Maaskas/Linefollower-2/readme.md

# LineFollower

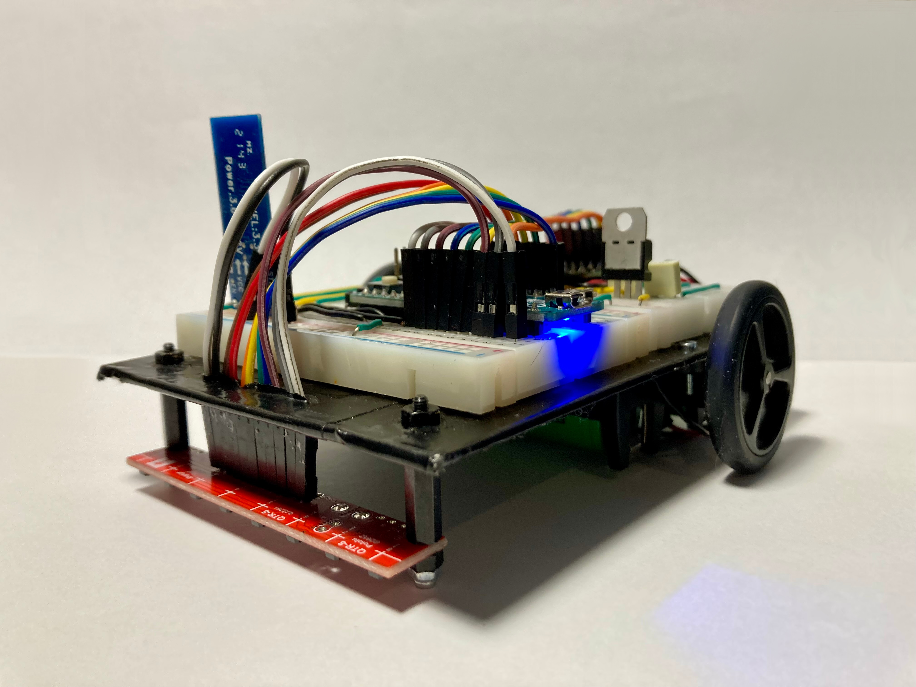
[picture p1: images/LFR.jpg]
A description of my image


## specifications

microcontroller: ATmega32U4

motors: 50:1 Geamotor 6V

h-bridge: TB6612FNG

sensors: QTR-8A

batteries: Sony US 18650VTC5C, 2500mAh, 30A

wireless communication: HC-05

distance sensor - motors: 85 mm

weight: 289 gram

speed: 0,82m/s
