Maaskas/Linefollower-2/code/proof of concepts/wireless communication/readme.md

# draadloze communicatie proof of concept
minimale hard- en software waarmee aangetoond wordt dat duplex kan gecommuniceerd worden tussen de microcontroller en een smartphone, gebruik makend van een Arduino programma
<br />
### configuratie

### opmerkingen

### gebruiksaanwijzing
