Maaskas/Linefollower-2/code/proof of concepts/sensor/readme.md

# Sensoren proof of concept

minimale hard- en software die aantoont dat minimaal 6 sensoren onafhankelijk van elkaar kunnen uitgelezen worden (geen calibratie, normalisatie of interpolatie). Hierbij moet een zo groot mogelijk bereik van de AD converter benut worden (indien van toepassing)

A description of my image
