Maaskas/Linefollower-2/images/IMG_2840.jpg

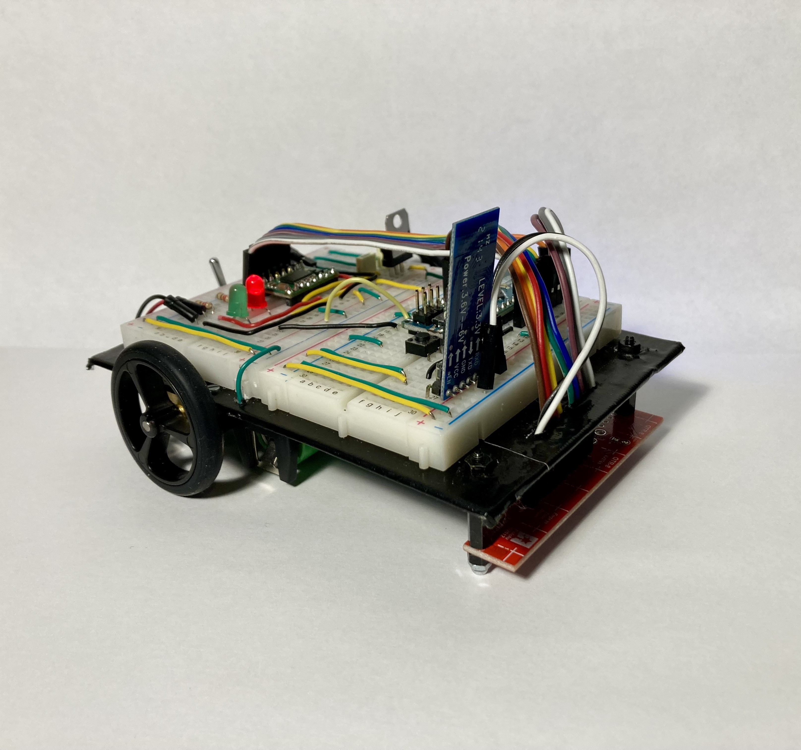
images/IMG_2840.jpg
