Maaskas/Linefollower-2/images/IMG_2842.jpg

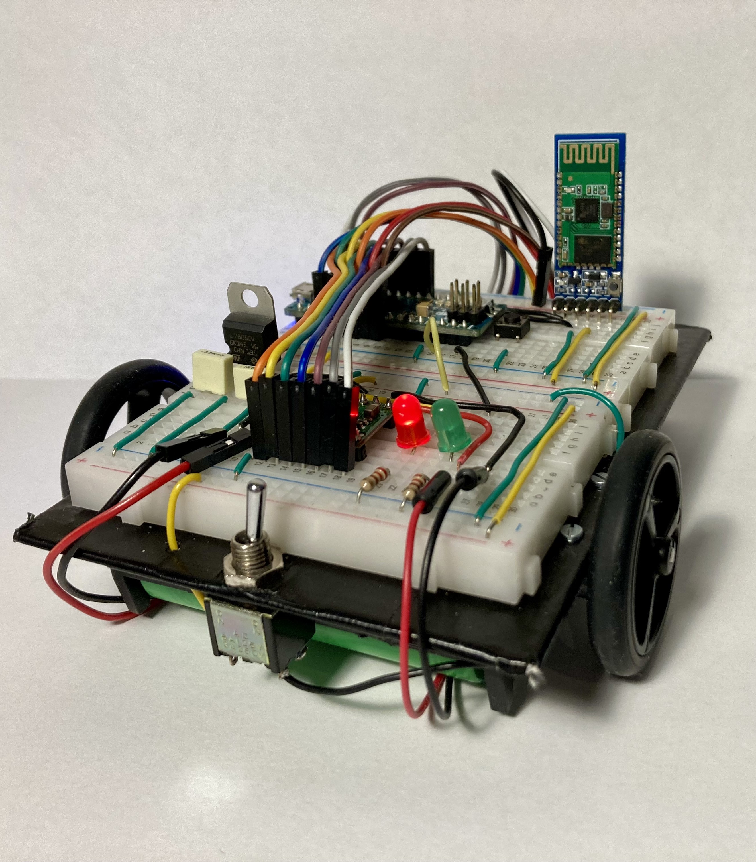
images/IMG_2842.jpg
