Maaskas/Linefollower-2/images/IMG_2843.jpg

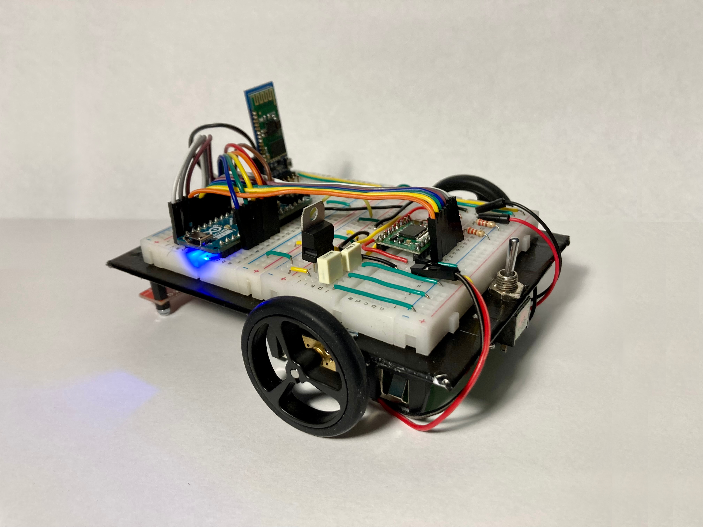
images/IMG_2843.jpg
