Maaskas/Linefollower-2/images/IMG_2844.jpg

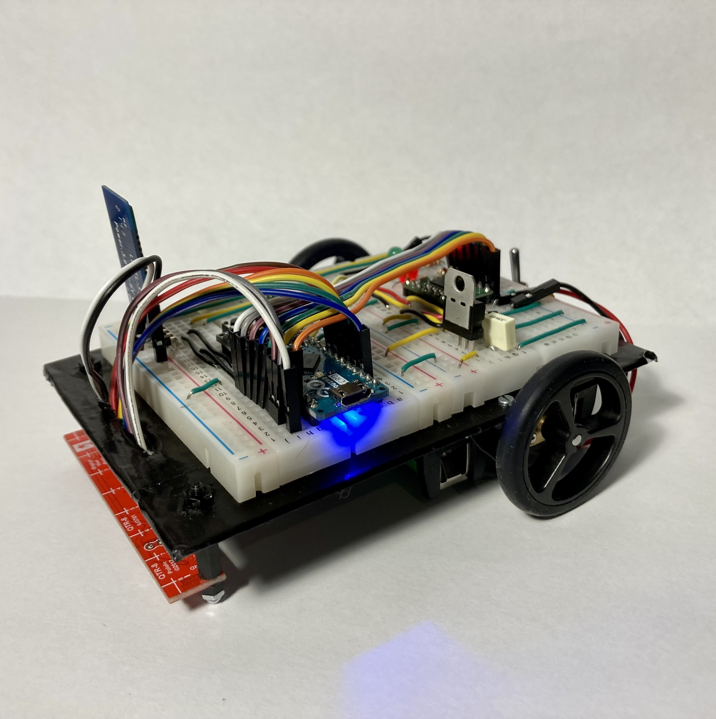
images/IMG_2844.jpg
