Maaskas/Linefollower-2/images/IMG_2846_.jpg

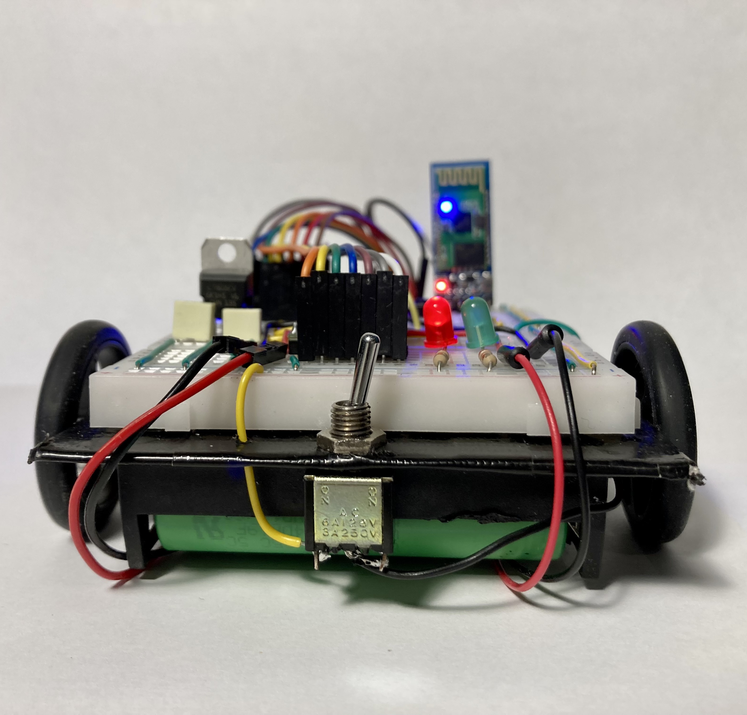
images/IMG_2846_.jpg
