Maaskas/Linefollower-2/images/IMG_2847.jpg

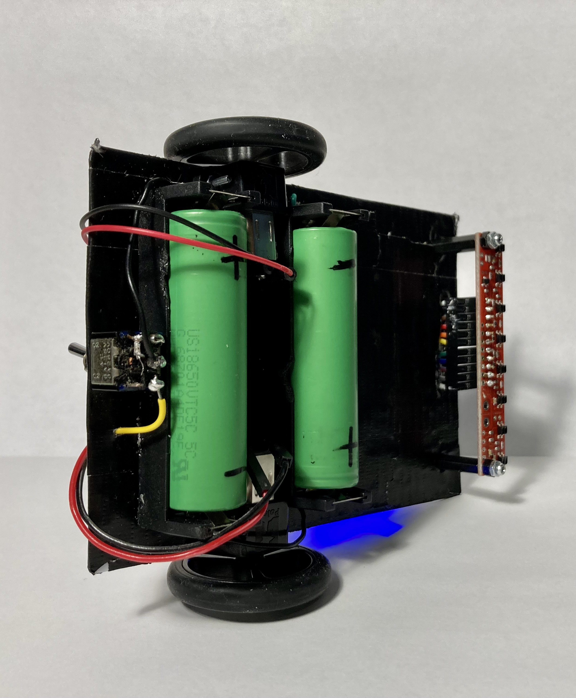
images/IMG_2847.jpg
