Maaskas/Linefollower-2/images/IMG_2848.jpg

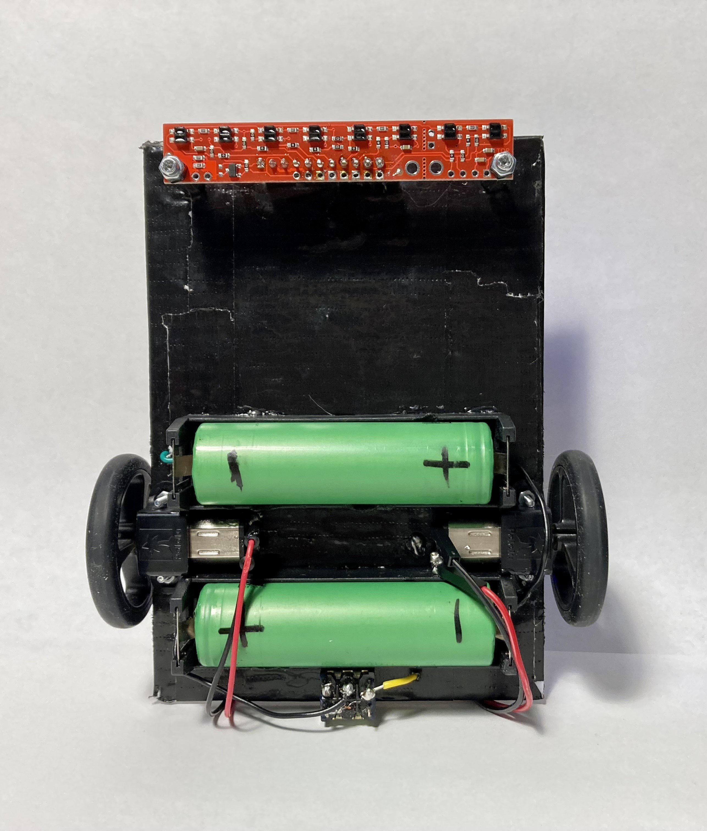
images/IMG_2848.jpg
