Maaskas/Linefollower-2/images/IMG_2853.jpg

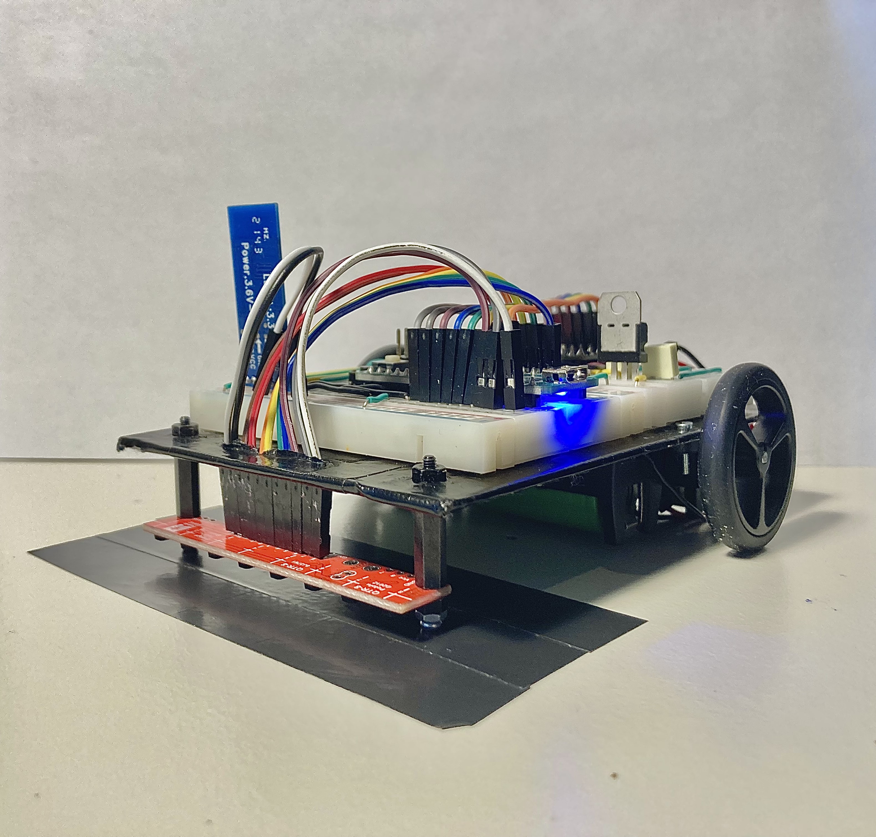
images/IMG_2853.jpg
