Maaskas/Linefollower-2/instructable/readme.md

# Instructable

De instructable kan ook op de website zelf bezocht worden via deze link:
https://www.instructables.com/Line-Following-Robot-8/

Die ziet er ook beter uit als de PDF dus dat is wel aangeraden ;)
