Maaskas/Linefollower-2/code/proof of concepts/wireless communication/Elektrisch Schema Proof of Concept HC-05.pdf

| | -S1

# Battery

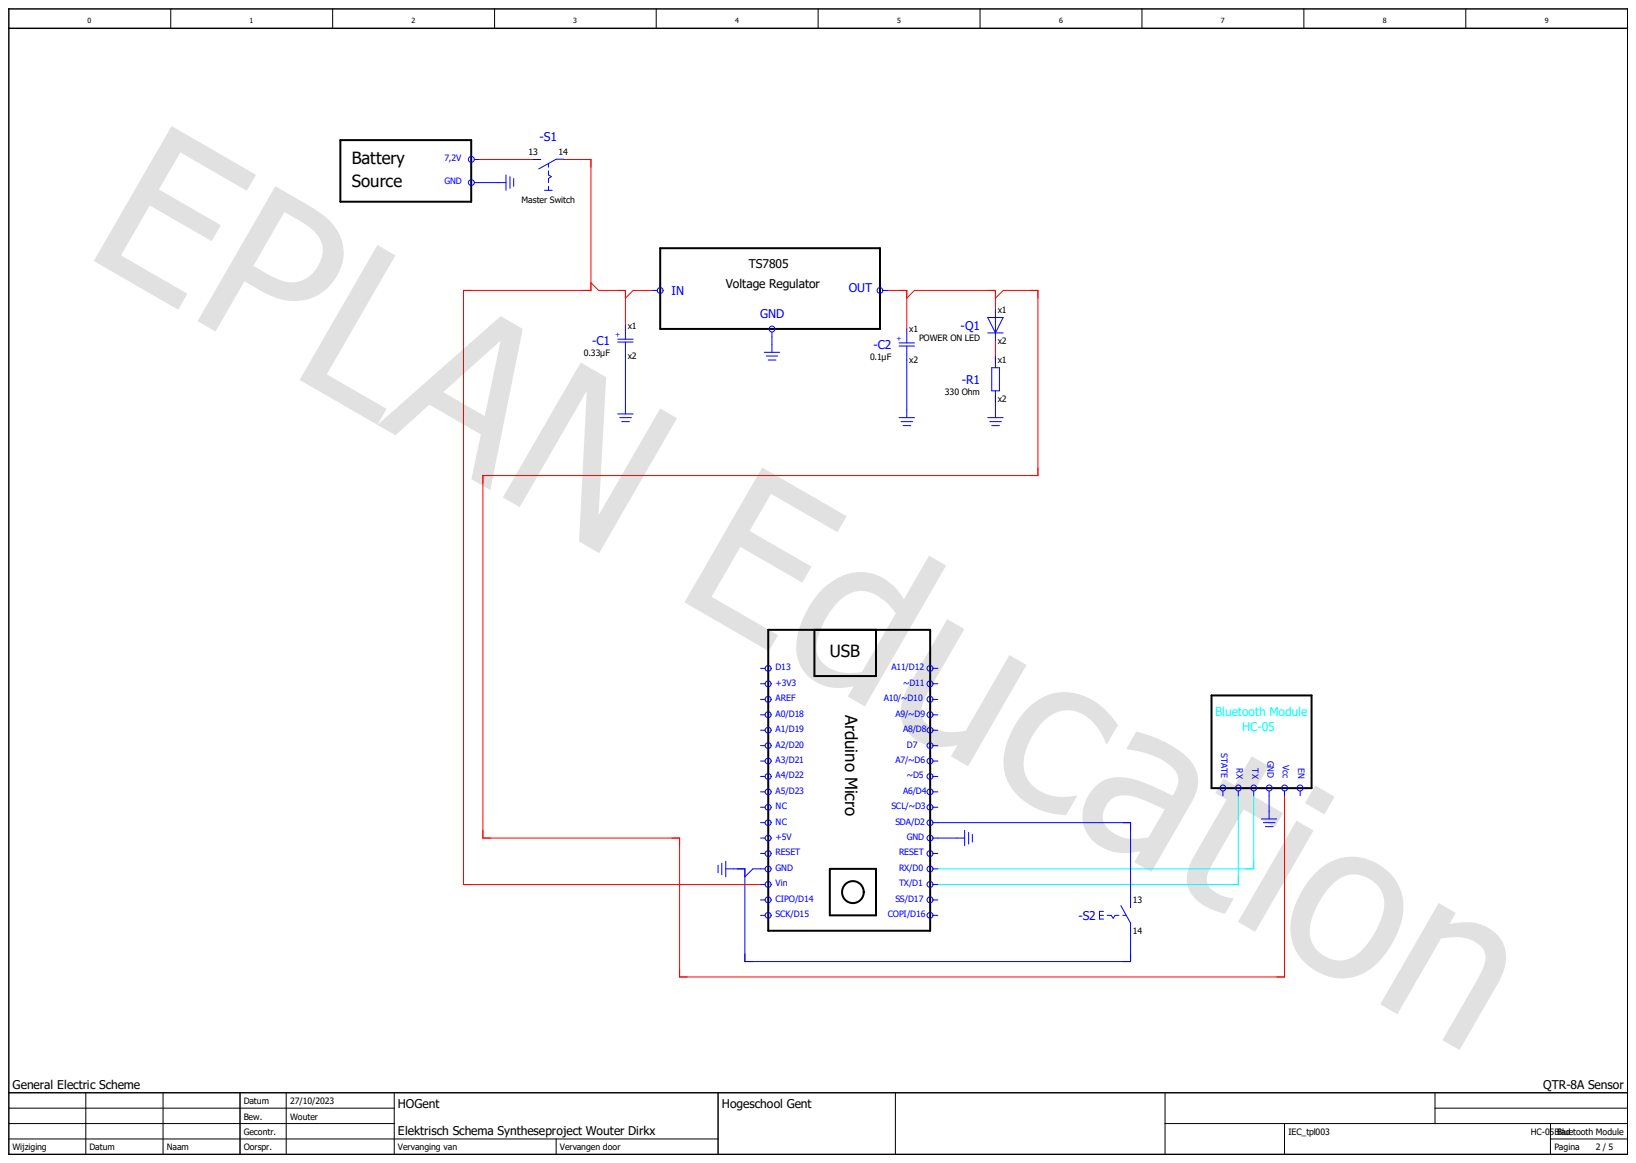
[picture p40: page 1]
QTR-8A Sensor; D13 +3V3 AREF A0/D18 A1/D19 A2/D20 A3/D21 A4/D22 A5/D23 NC NC +5V RESET GND Vin CIPO/D14 SCK/D15; A11/D12 ~D11 A10/~D10 A9/~D9 A8/D8 D7 A7/~D6 ~D5 A6/D4 SCL/~D3 SDA/D2 GND RESET RX/D0 TX/D1 SS/D17; COPI/D16 Arduino Micro; STATERXTX GNDVcc; Bluetooth Module; HC-05 USB; Source; GND; Voltage Regulator IN; OUT; Master Switch; -R1 330 Ohm; -Q1 POWER ON LED

General Electric Scheme

Datum | 27/10/2023 | HOGent Elektrisch Schema Syntheseproject Wouter Dirkx | Hogeschool Gent
Bew. | Wouter
Gecontr. | | | | IEC_tpl003 HC-05 Bluetooth Module | Blad

Wijziging | Datum | Naam | Oorspr. | | Vervanging van | Vervangen door | | | Pagina 2 / 5
