Maaskas/Linefollower-2/code/proof of concepts/sensor/Elektrisch Schema Proof of Concept QTR8A.pdf

| | -S1

# Battery

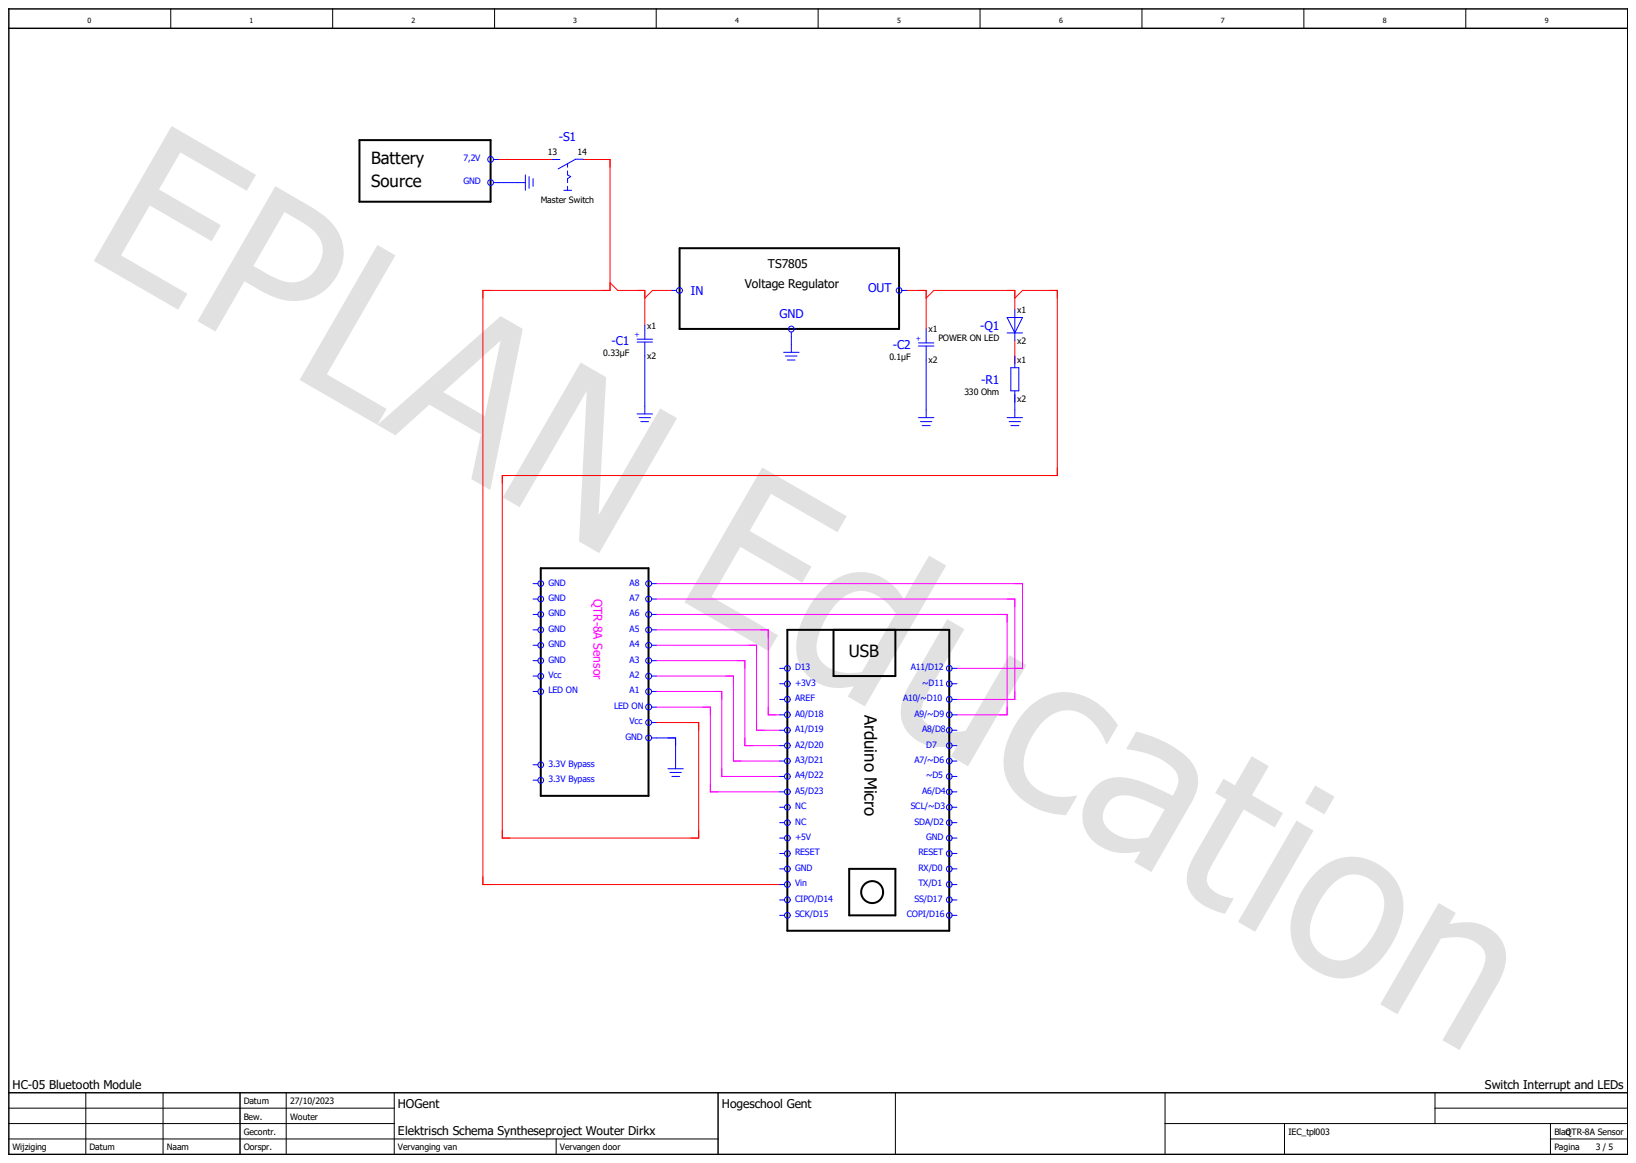
[picture p41: page 1]
D13 +3V3 AREF A0/D18 A1/D19 A2/D20 A3/D21 A4/D22 A5/D23 NC NC +5V RESET GND Vin CIPO/D14 SCK/D15; A11/D12 ~D11 A10/~D10 A9/~D9 A8/D8 D7 A7/~D6 ~D5 A6/D4 SCL/~D3 SDA/D2 GND RESET RX/D0 TX/D1 SS/D17; COPI/D16 Arduino Micro; A8 A7 A6 A5 A4 A3 A2 A1 LED ON Vcc; GND; USB; Vcc LED ON; 3.3V Bypass; 3.3V BypassQTR-8A Sensor; Source; GND GND GND GND GND; Voltage Regulator IN; OUT; Master Switch; -R1 330 Ohm; -Q1 POWER ON LED

HC-05 Bluetooth Module

Switch Interrupt and LEDs

Datum | 27/10/2023 | HOGent Elektrisch Schema Syntheseproject Wouter Dirkx | Hogeschool Gent
Bew. | Wouter
Gecontr. | | | | IEC_tpl003 | Blad QTR-8A Sensor

Wijziging | Datum | Naam | Oorspr. | | Vervanging van | Vervangen door | | | Pagina 3 / 5
