Maaskas/Linefollower-2/code/proof of concepts/interrupt/Elektrisch Schema Proof of Concept Switch Interrupt.pdf

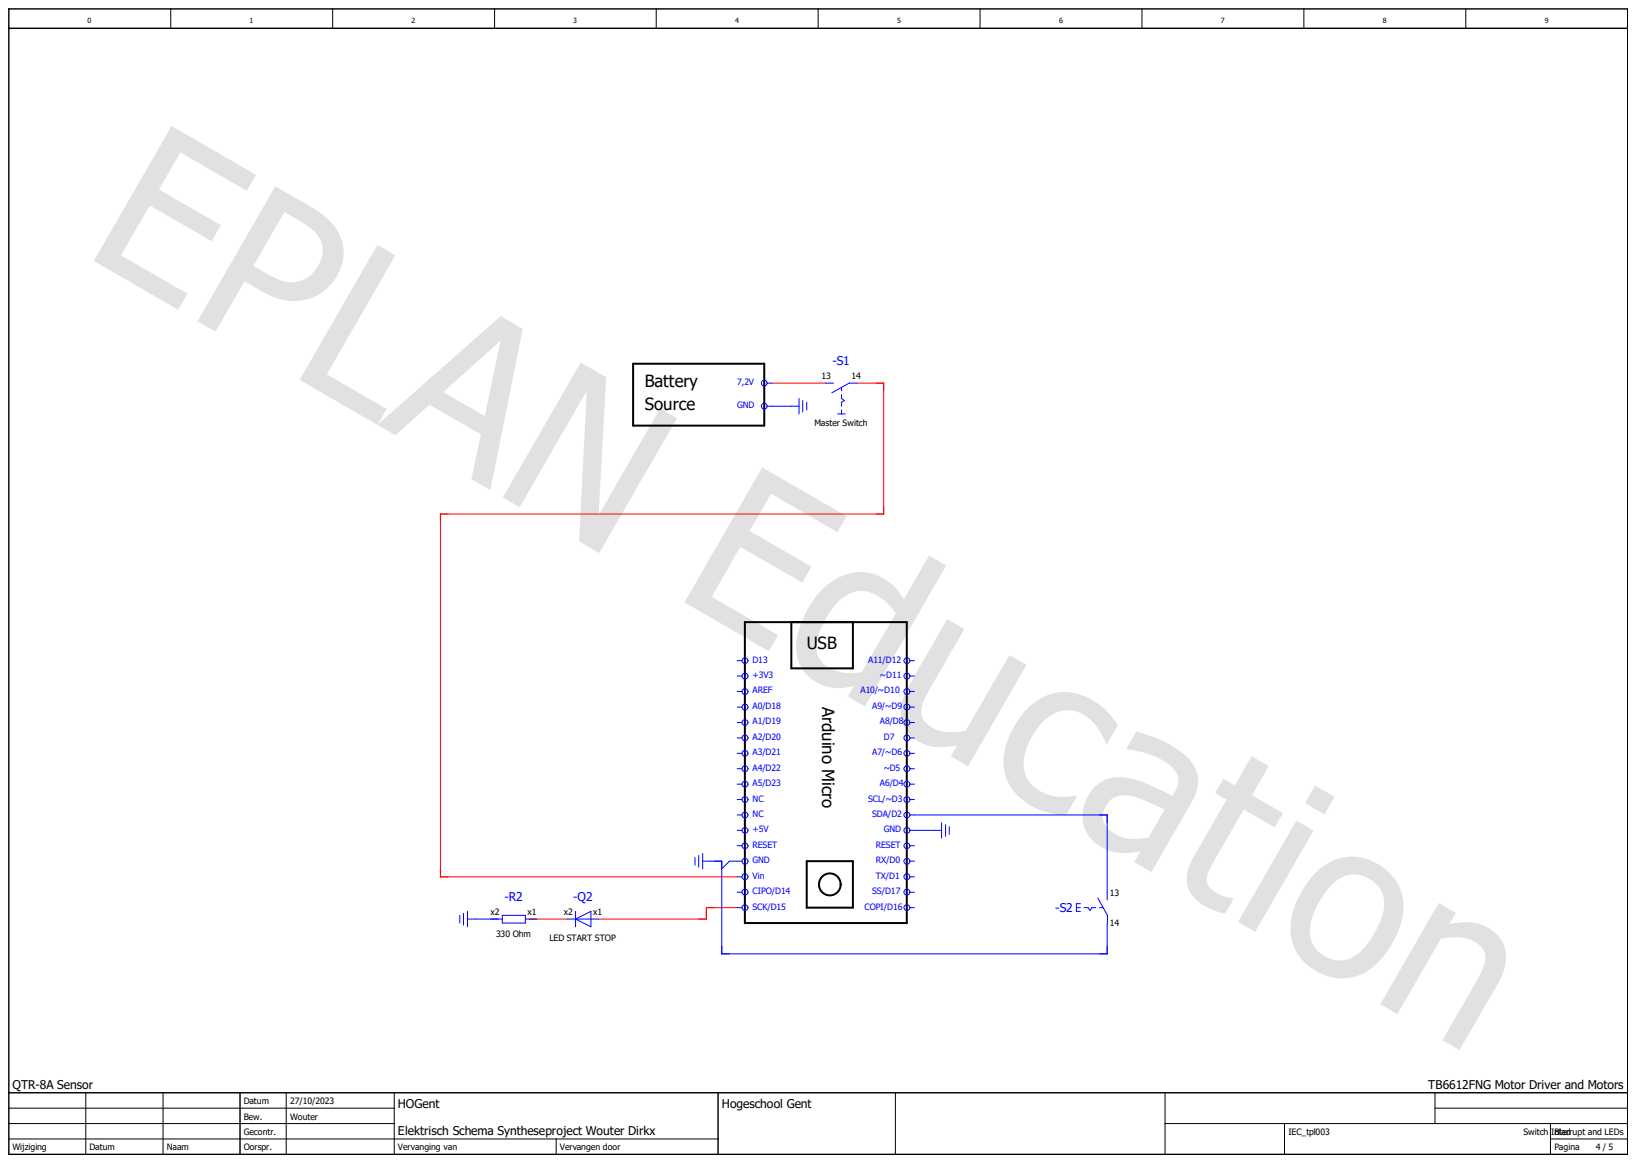
[picture p42: page 1]
QTR-8A Sensor; D13 +3V3 AREF A0/D18 A1/D19 A2/D20 A3/D21 A4/D22 A5/D23 NC NC +5V RESET GND Vin CIPO/D14 SCK/D15; A11/D12 ~D11 A10/~D10 A9/~D9 A8/D8 D7 A7/~D6 ~D5 A6/D4 SCL/~D3 SDA/D2 GND RESET RX/D0 TX/D1 SS/D17; Battery; Source; GND; Master Switch; 330 Ohm

USB
COPI/D16 Arduino Micro

LED START STOP

TB6612FNG Motor Driver and Motors

Datum | 27/10/2023 | HOGent Elektrisch Schema Syntheseproject Wouter Dirkx | Hogeschool Gent
Bew. | Wouter
Gecontr. | | | | IEC_tpl003 Switch Interrupt and LEDs | Blad

Wijziging | Datum | Naam | Oorspr. | | Vervanging van | Vervangen door | | | Pagina 4 / 5
