Maaskas/Linefollower-2/code/proof of concepts/hbridge/Elektrisch Schema Proof of Concept TB6612FNG.pdf

| | -S1

# Battery

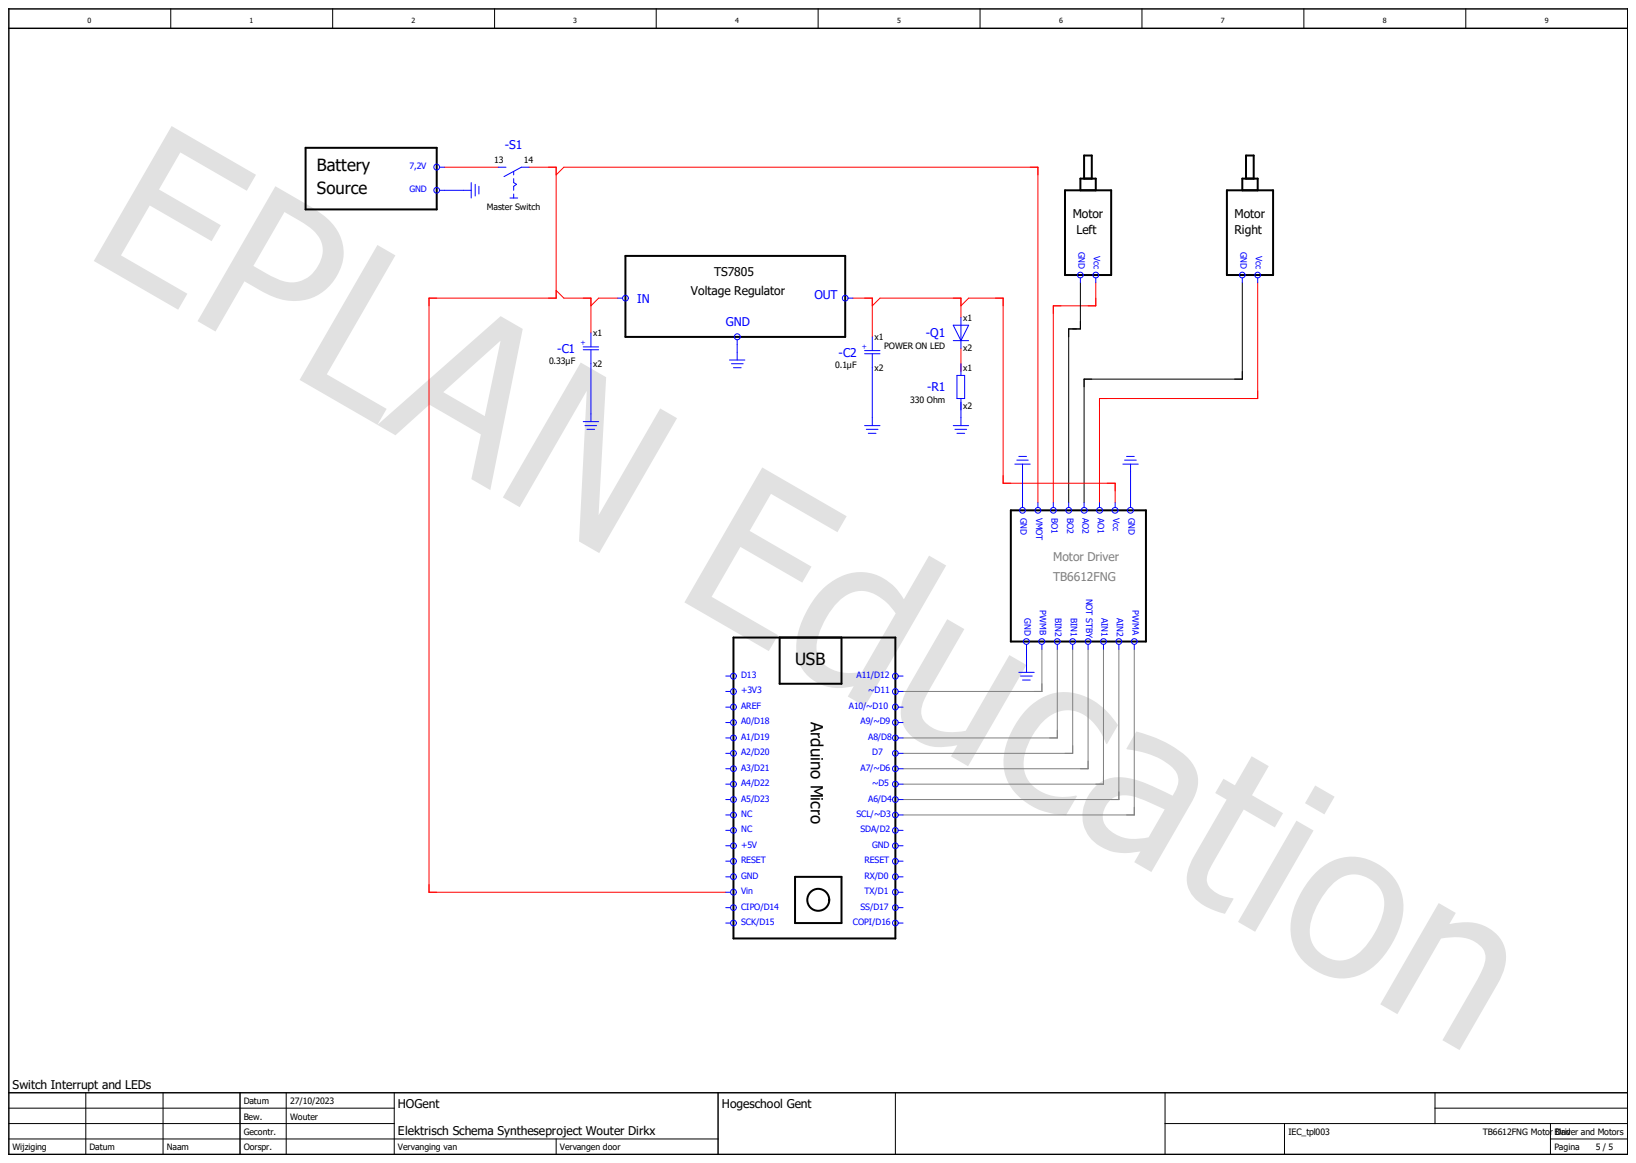
[picture p43: page 1]
D13 +3V3 AREF A0/D18 A1/D19 A2/D20 A3/D21 A4/D22 A5/D23 NC NC +5V RESET GND Vin CIPO/D14 SCK/D15; A11/D12 ~D11 A10/~D10 A9/~D9 A8/D8 D7 A7/~D6 ~D5 A6/D4 SCL/~D3 SDA/D2 GND RESET RX/D0 TX/D1 SS/D17; USB; GND VMOT BO1 BO2 AO2 AO1 Vcc; GND GND PWMB BIN2 BIN1 NOT STBY AIN1 AIN2 PWMA; Source; GNDVcc; Motor; Left; Right; GND; Voltage Regulator IN; OUT; Master Switch; -R1 330 Ohm; -Q1 POWER ON LED

Motor Driver
TB6612FNG
COPI/D16 Arduino Micro

Switch Interrupt and LEDs

Datum | 27/10/2023 | HOGent Elektrisch Schema Syntheseproject Wouter Dirkx | Hogeschool Gent
Bew. | Wouter
Gecontr. | | | | IEC_tpl003 TB6612FNG Motor Driver and Motors | Blad

Wijziging | Datum | Naam | Oorspr. | | Vervanging van | Vervangen door | | | Pagina 5 / 5
