Maaskas/Linefollower-2/(list of files, drawings)

Other design files:
technische tekeningen/elektronisch/easyeda_linefollower_planB.json
