Maaskas/Linefollower-2/code/proof of concepts/sensor/QTR8A_Proof_of_Concept_code.ino

void setup() {
  Serial.begin(9600);           //  setup serial
}

void loop() {
  
//Print all analog values in a row of 8 colums each 250 ms
  Serial.print(analogRead(A5));
  Serial.print(" ");
  
  Serial.print(analogRead(A4));
  Serial.print(" ");
  
  Serial.print(analogRead(A3));
  Serial.print(" ");
  
  Serial.print(analogRead(A2));
  Serial.print(" ");
  
  Serial.print(analogRead(A1));
  Serial.print(" ");
  
  Serial.print(analogRead(A9));
  Serial.print(" ");
  
  Serial.print(analogRead(A10));
  Serial.print(" ");
  
  Serial.print(analogRead(A11));


  Serial.println("");
  delay (500);
}
